jBommottet/TB-Driver-Brushless/Driver050621/CommandBoard/Project Outputs for CommandBoard/CommandBoard.xlsx

Comment | Designator | Quantity | Mouser number | Digikey number | Other number | Link
CAP CER 10uF 0603 |  | 4 |  | C0603C106M8PAC7867 |  | https://www.digikey.ch/product-detail/fr/C0603C106M8PAC7867/399-14945-1-ND/7382494?itemSeq=363421899
CAP CER 4.7uF 0603 |  | 2 |  | C0603C475K9PACTU |  | https://www.digikey.ch/product-detail/fr/kemet/C0603C475K9PACTU/399-3482-1-ND/754775
CAP CER 1uF 0603 |  | 1 |  | C0603C105K4RACTU |  | https://www.digikey.ch/product-detail/fr/C0603C105K4RACTU/399-7847-1-ND/3471570?itemSeq=363415969
CAP CER 1nF 0603 |  | 3 |  | C0603C102K8RACTU |  | https://www.digikey.ch/product-detail/fr/C0603C102K8RACTU/399-8984-1-ND/3522501?itemSeq=363415954
CAP CER 100nF 0603 |  | 25 |  | C0603C104K8RACTU |  | https://www.digikey.ch/product-detail/fr/C0603C104K8RACTU/399-1095-1-ND/411370?itemSeq=363415948
CAP CER 4.7nF 0603 |  | 18 |  | C0603C475M8PACTU |  | https://www.digikey.ch/product-detail/fr/C0603C475M8PACTU/399-9100-1-ND/3522617?itemSeq=363422440
CAP CER 22uF 0603 |  | 16 |  | C0603C226M9PACTU |  | https://www.digikey.ch/product-detail/fr/C0603C226M9PACTU/399-C0603C226M9PACTUCT-ND/14010171?itemSeq=363420624
DIODE SCHOTTKY 10V 2A SMA |  | 2 |  | MBRA210LT3G |  | https://www.digikey.ch/product-detail/fr/MBRA210LT3G/MBRA210LT3GOSCT-ND/917974?itemSeq=363445154
DIODE ZENER 6.8V 1W SMA |  | 1 |  | SMAZ6V8-13-F |  | https://www.digikey.ch/product-detail/fr/SMAZ6V8-13-F/SMAZ6V8-FDICT-ND/725075?itemSeq=363447033
FUSE 1.5A 5V FAST 0603 SMD |  | 1 |  | 04000026NR |  | https://www.digikey.ch/product-detail/fr/04000026NR/F12132CT-ND/10271167?itemSeq=363445570
CONNECT 2pos 90° |  | 2 |  |  | 62000211121 | https://www.we-online.com/catalog/en/PHD_2_00_THT_PIN_HEADER_6200XX11121
IND SMD 2020 |  | 1 |  | TFM201610ALM-R47MTAA |  | https://www.digikey.ch/product-detail/fr/tdk-corporation/TFM201610ALM-R47MTAA/445-174184-1-ND/5812324
IND SMD 6.8UH 0603 |  | 1 |  | MLF1608E6R8JTD25 |  | https://www.digikey.ch/product-detail/fr/MLF1608E6R8JTD25/445-173923-1-ND/5808629?itemSeq=363423079
RES SMD 2K2 0603 |  | 3 |  | RMCF0603FT2K20 |  | https://www.digikey.ch/product-detail/fr/stackpole-electronics-inc/RMCF0603FT2K20/RMCF0603FT2K20CT-ND/1943011
RES SMD 100R 0603 |  | 1 |  | RMCF0603FT100R |  | https://www.digikey.ch/product-detail/fr/RMCF0603FT100R/RMCF0603FT100RCT-ND/1942965?itemSeq=363423585
RES SMD 4.7k 0603 |  | 2 |  | RMCF0603FT4K70 |  | https://www.digikey.ch/product-detail/fr/RMCF0603FT4K70/RMCF0603FT4K70CT-ND/1943033?itemSeq=363423649
RES SMD 10R 0603 |  | 1 |  | RNCP0603FTD10R0 |  | https://www.digikey.ch/product-detail/fr/stackpole-electronics-inc/RNCP0603FTD10R0/RNCP0603FTD10R0CT-ND/2240413
RES SMD 120R 0603 |  | 1 |  | RMCF0603FT120R |  | https://www.digikey.ch/product-detail/fr/RMCF0603FT120R/RMCF0603FT120RCT-ND/1942967?itemSeq=363423557
RES 10K SMD 0603 |  | 18 |  | RMCF0603FT10K0 |  | https://www.digikey.ch/product-detail/fr/RMCF0603FT10K0/RMCF0603FT10K0CT-ND/1943057?itemSeq=363415693
DC DC CONVERTER 5V-3.3V |  | 1 |  | MPM3805GQB-33-Z |  | https://www.digikey.ch/product-detail/fr/MPM3805GQB-33-Z/1589-1986-1-ND/9748501?itemSeq=363447105
DC DC CONVERTER 5V-1.2V |  | 1 |  | MPM3805GQB-12-Z |  | https://www.digikey.ch/product-detail/fr/MPM3805GQB-12-Z/1589-1983-1-ND/9748498?itemSeq=363447114
DC DC CONVERTER 5V-12V |  | 1 |  | MEE3S0512SC |  | https://www.digikey.ch/product-detail/fr/MEE3S0512SC/811-2358-5-ND/3029000?itemSeq=363441799
IC TRANSCEIVER CAN |  | 1 |  | SN65HVD231QDRQ1 |  | https://www.digikey.ch/product-detail/fr/SN65HVD231QDRQ1/296-15380-1-ND/571269?itemSeq=363441788
SUPERVISOR 1 CHANNEL |  | 1 |  | ADM823TYRJZ-R7 |  | https://www.digikey.ch/product-detail/fr/ADM823TYRJZ-R7/ADM823TYRJZ-R7CT-ND/2467723?itemSeq=363441633
DSP TMS320F28388D |  | 1 | 595-F28388DPTPS |  |  | https://www.mouser.ch/ProductDetail/Texas-Instruments/F28388DPTPS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
RAM |  | 1 |  | AS6C4008-55SINTR |  | https://www.digikey.ch/product-detail/fr/AS6C4008-55SINTR/1450-AS6C4008-55SINCT-ND/12088888?itemSeq=364804926
CONNECT SMD 16pos 180° |  | 2 |  |  | 62101621021 | https://www.we-online.com/catalog/en/PHD_1_27_SMT_DUAL_PIN_HEADER_6210XX21021
CONNECT SMD 10pos 180° |  | 2 |  |  | 62131021021
CONNECT 2pos 90° |  | 1 |  | 395126002 |  | https://www.digikey.ch/product-detail/fr/molex/0395126002/WM25774-ND/2736022 | + connecteur opposé
CONNECT SMD 14pos 180° |  | 3 |  |  | 62101421021 | https://www.we-online.com/catalog/en/PHD_1_27_SMT_DUAL_PIN_HEADER_6210XX21021
CONNECT SMD 5pos 180° |  | 3 |  |  | 62000611121 | https://www.we-online.com/catalog/en/PHD_2_00_THT_PIN_HEADER_6200XX11121
CONNECT SMD 4pos 180° |  | 4 |  | 215079-4 |  | https://www.digikey.ch/product-detail/fr/te-connectivity-amp-connectors/215079-4/A107031CT-ND/3488592
CRYSTAL 12.0000MHZ |  | 1 |  | CX3225SB12000D0GZJC1 |  | https://www.digikey.ch/product-detail/fr/CX3225SB12000D0GZJC1/1253-1696-1-ND/5995243?itemSeq=364400560
