jBommottet/TB-Driver-Brushless/Driver050621/DCDC_5V/Project Outputs for DCDC_5V/DCDC_5V.xlsx

Comment | Quantity | Digikey number | Other number | Link
CAP CER 3.3uF 1206 | 1 | CGA5L3X7S2A335K160AB |  | https://www.digikey.ch/product-detail/fr/CGA5L3X7S2A335K160AB/445-15583-1-ND/4278756?itemSeq=363420762
CAP CER 2.2uF 1206 | 1 | CNC5L1X7R1N225K160AE |  | https://www.digikey.ch/product-detail/fr/CNC5L1X7R1N225K160AE/445-181654-1-ND/10240641?itemSeq=363420761
CAP CER 22uF 0603 | 1 | C0603C226M9PACTU |  | https://www.digikey.ch/product-detail/fr/C0603C226M9PACTU/399-C0603C226M9PACTUCT-ND/14010171?itemSeq=363420624
DIODE SCHOTTKY 100V 1A SOD123 | 2 | PMEG10010ELRX |  | https://www.digikey.ch/product-detail/fr/PMEG10010ELRX/1727-2394-1-ND/5436140?itemSeq=363416438
IND SMD 4.7uH 2020 | 1 | DFE252012F-4R7M=P2 |  | https://www.digikey.ch/product-detail/fr/DFE252012F-4R7M%3dP2/490-13051-1-ND/5812763?itemSeq=363420526
DCDC 5V 1.5A | 1 | RPMH5.0-1.5 |  | https://www.digikey.ch/product-detail/fr/RPMH5.0-1.5/945-RPMH5.0-1.5CT-ND/13549175?itemSeq=363421652
CONNECT HEADER 5pos 180° | 1 |  | 62000611821 | https://www.we-online.com/catalog/en/PHD_2_00_SOCKET_HEADER_6200XX11821
