jBommottet/TB-Driver-Brushless/Driver050621/PowerBoard/Project Outputs for PowerBoard/PowerBoard.xlsx

LISTE POUR 1 CARTE
Comment | Quantity | Mouser number | Digikey number | Other number | Link
CAP CER 10uF 1210 | 20 |  | C3225X7R1N106K250AC |  | https://www.digikey.ch/product-detail/fr/tdk-corporation/C3225X7R1N106K250AC/445-C3225X7R1N106K250ACCT-ND/10415004
CAP CER 100nF 0603 | 4 |  | C0603C104K8RACTU |  | https://www.digikey.ch/product-detail/fr/C0603C104K8RACTU/399-1095-1-ND/411370?itemSeq=363415948
CAP CER 1nF 0603 | 6 |  | C0603C102K8RACTU |  | https://www.digikey.ch/product-detail/fr/C0603C102K8RACTU/399-8984-1-ND/3522501?itemSeq=363415954
CAP CER 1uF 0603 | 6 |  | C0603C105K4RACTU |  | https://www.digikey.ch/product-detail/fr/C0603C105K4RACTU/399-7847-1-ND/3471570?itemSeq=363415969
CAP CER 47nF 0603 | 4 |  | C0603C473K8RAC7867 |  | https://www.digikey.ch/product-detail/fr/C0603C473K8RAC7867/399-14522-1-ND/7103814?itemSeq=363415965
CAP CER 4.7nF 0603 | 2 |  | C0603C472K8RACTU |  | https://www.digikey.ch/product-detail/fr/C0603C472K8RACTU/399-9092-1-ND/3522609?itemSeq=363415967
CAP CER 22uF 0603 | 2 |  | JMK107BBJ226MA-T |  | https://www.digikey.ch/product-detail/fr/taiyo-yuden/JMK107BBJ226MA-T/587-5444-2-ND/7067029
DIODE SCHOTTKY 100V 1A SOD123 | 3 |  | PMEG10010ELRX |  | https://www.digikey.ch/product-detail/fr/PMEG10010ELRX/1727-2394-1-ND/5436140?itemSeq=363416438
CONNECT 2pos 90° | 1 |  | 1778764 |  | https://www.digikey.ch/product-detail/fr/1778764/277-2315-1-ND/2625585?itemSeq=363625166 | + connecteur opposé
CONNECT 3pos 90° | 1 |  | 1778777 |  | https://www.digikey.ch/product-detail/fr/1778777/277-2316-1-ND/2625586?itemSeq=363625120 | + connecteur opposé
IND SMD 220nH 1008 | 1 |  | SRP2510A-R22M |  | https://www.digikey.ch/product-detail/fr/bourns-inc/SRP2510A-R22M/SRP2510A-R22MCT-ND/7354833
MOSFET N-CH 80V | 6 |  | NTMFSC004N08MC |  | https://www.digikey.ch/product-detail/fr/NTMFSC004N08MC/488-NTMFSC004N08MCCT-ND/12181457?itemSeq=363416444
RES 18K SMD 0603 | 4 |  | RMCF0603FT18K0 |  | https://www.digikey.ch/product-detail/fr/RMCF0603FT18K0/RMCF0603FT18K0CT-ND/2417954?itemSeq=363415700
RES 1K SMD 0603 | 6 |  | RMCF0603FT1K00 |  | https://www.digikey.ch/product-detail/fr/RMCF0603FT1K00/RMCF0603FT1K00CT-ND/1942996?itemSeq=363415659
RES 5R6 SMD 0603 | 6 |  | RMCF0603FT5R60 |  | https://www.digikey.ch/product-detail/fr/RMCF0603FT5R60/738-RMCF0603FT5R60CT-ND/4425116?itemSeq=363415636
RES 220R SMD 0603 | 6 |  | RMCF0603FT220R |  | https://www.digikey.ch/product-detail/fr/RMCF0603FT220R/RMCF0603FT220RCT-ND/1942973?itemSeq=363415651
RES 20k SMD 0603 | 2 |  | RMCF0603FT20K0 |  | https://www.digikey.ch/product-detail/fr/RMCF0603FT20K0/RMCF0603FT20K0CT-ND/1943075?itemSeq=363415704
RES 10K SMD 0603 | 2 |  | RMCF0603FT10K0 |  | https://www.digikey.ch/product-detail/fr/RMCF0603FT10K0/RMCF0603FT10K0CT-ND/1943057?itemSeq=363415693
SENSOR DIGITAL -40C-150C | 1 |  | ADT7301ARTZ-REEL7 |  | https://www.digikey.ch/product-detail/fr/ADT7301ARTZ-REEL7/ADT7301ARTZ-REEL7CT-ND/1140631?itemSeq=363416449
Op Amp 4ch | 1 |  | MCP629-E/ML |  | https://www.digikey.ch/product-detail/fr/MCP629-E%2fML/MCP629-E%2fML-ND/2721005?itemSeq=363416452
GATE DRIVER 2.5A | 6 |  | SI8220BB-D-ISR |  | https://www.digikey.ch/product-detail/fr/SI8220BB-D-ISR/336-4765-1-ND/8611031?itemSeq=363416457
Op Amp 2ch | 1 | MCP622-E/MF |  |  | https://www.mouser.ch/ProductDetail/Microchip-Technology/MCP622-E-MF?qs=E6wAi2XWqcMnrAekjrllAQ%3D%3D
Analog Switch 2:1 2ch | 1 | ADG854BCPZ-REEL7 |  |  | https://www.mouser.ch/ProductDetail/Analog-Devices/ADG854BCPZ-REEL7?qs=BpaRKvA4VqFJEnBHLg6w9Q%3D%3D
IC CURRENT SENSOR | 2 |  | MLX91221KDC-ABF-025-SP |  | https://www.digikey.ch/product-detail/fr/melexis-technologies-nv/MLX91221KDC-ABF-025-SP/413-MLX91221KDC-ABF-025-SP-ND/13572120
CONNECT SMD 16pos 2row 180° | 1 |  |  | 62301621021 | https://www.we-online.com/catalog/en/PHD_1_27_SMT_DUAL_SOCKET_HEADER_6230XX21021
CONNECT SMD 10pos 2row 180° | 1 |  |  | 62301021021
