jBommottet/TB-Driver-Brushless/Driver050621/InterfaceBoard/Project Outputs for InterfaceBoard/InterfaceBoard.xlsx

LISTE POUR 1 CARTE
Comment | Quantity | Digikey number | Other number | Link
CAP CER 1nF 0603 | 3 | C0603C102K8RACTU |  | https://www.digikey.ch/product-detail/fr/C0603C102K8RACTU/399-8984-1-ND/3522501?itemSeq=363415954
CAP CER 10nF 0603 | 1 | C0603C103K8RACTU |  | https://www.digikey.ch/product-detail/fr/C0603C103K8RACTU/399-11132-1-ND/4357813?itemSeq=363415943
CAP CER 100nF 0603 | 14 | C0603C104K8RACTU |  | https://www.digikey.ch/product-detail/fr/C0603C104K8RACTU/399-1095-1-ND/411370?itemSeq=363415948
CAP CER 10pF 0603 | 4 | C0603C100K8RAC7867 |  | https://www.digikey.ch/product-detail/fr/C0603C100K8RAC7867/399-17563-1-ND/8572563?itemSeq=363415936
CAP CER 22uF 0603 | 1 | JMK107BBJ226MA-T |  | https://www.digikey.ch/product-detail/fr/taiyo-yuden/JMK107BBJ226MA-T/587-5444-2-ND/7067029
CONNECT SMD 6pos 180° | 2 | 7-188275-6 |  | https://www.digikey.ch/product-detail/fr/7-188275-6/A99474CT-ND/1955776?itemSeq=363420047
CONNECT SMD 8pos 180° | 2 | 7-188275-8 |  | https://www.digikey.ch/product-detail/fr/7-188275-8/A99475CT-ND/1955777?itemSeq=363420050
CONNECT 2pos 180° | 1 |  | 62000211821 | https://www.we-online.com/catalog/en/PHD_2_00_SOCKET_HEADER_6200XX11821
IND SMD 2.2uH 0603 | 1 | MLZ1608N2R2LT000 |  | https://www.digikey.ch/product-detail/fr/tdk-corporation/MLZ1608N2R2LT000/445-6754-1-ND/2523575
RES SMD 10R 0603 | 1 | RMCF0603FT10R0 |  | https://www.digikey.ch/product-detail/fr/RMCF0603FT10R0/RMCF0603FT10R0CT-ND/1942943?itemSeq=363415646
RES SMD 560R 0603 | 6 | RMCF0603FT560R |  | https://www.digikey.ch/product-detail/fr/RMCF0603FT560R/738-RMCF0603FT560RCT-ND/4425112?itemSeq=363415656
RES SMD 1K 0603 | 9 | RMCF0603FT1K00 |  | https://www.digikey.ch/product-detail/fr/RMCF0603FT1K00/RMCF0603FT1K00CT-ND/1942996?itemSeq=363415659
RES SMD 2K2 0603 | 3 | RMCF0603FT2K20 |  | https://www.digikey.ch/product-detail/fr/RMCF0603FT2K20/RMCF0603FT2K20CT-ND/1943011?itemSeq=363415690
RES SMD 10K 0603 | 8 | RMCF0603FT10K0 |  | https://www.digikey.ch/product-detail/fr/RMCF0603FT10K0/RMCF0603FT10K0CT-ND/1943057?itemSeq=363415693
RES SMD 0603 | 2 | RNCS0603BKE10K0 |  | https://www.digikey.ch/product-detail/fr/stackpole-electronics-inc/RNCS0603BKE10K0/RNCS0603BKE10K0CT-ND/1800113
IC ADC 12BIT | 1 | ADS7883SDBVT |  | https://www.digikey.ch/product-detail/fr/ADS7883SDBVT/296-23635-1-ND/1919069?itemSeq=363416073
Analog Switch 2:1 1ch | 5 | NC7SB3157P6X |  | https://www.digikey.ch/product-detail/fr/NC7SB3157P6X/NC7SB3157P6XCT-ND/1305384?itemSeq=365255241
OPAMP 1 CIRCUIT | 3 | TS951RIYLT |  | https://www.digikey.ch/product-detail/fr/stmicroelectronics/TS951RIYLT/497-15708-1-ND/5267991
IC INVERTER 3CH | 1 | TC7WH14FU,LJ(CT |  | https://www.digikey.ch/product-detail/fr/toshiba-semiconductor-and-storage/TC7WH14FU-LJ-CT/TC7WH14FULJ-CTCT-ND/870765
COMP 1 CIRCUIT | 3 | LMV7239M5/NOPB |  | https://www.digikey.ch/product-detail/fr/texas-instruments/LMV7239M5-NOPB/LMV7239M5-NOPBCT-ND/638723
IC RECEIVER 0/4 | 1 | AM26C32IPWR |  | https://www.mouser.ch/ProductDetail/Texas-Instruments/AM26C32IPWR?qs=iSMark9AYDVYrMWEOajyrw%3D%3D
CONNECT SMD 16pos 180° | 1 |  | 62301621021 | https://www.we-online.com/catalog/en/PHD_1_27_SMT_DUAL_SOCKET_HEADER_6230XX21021
CONNECT HEADER 5pos 180° | 1 |  | 62000611821 | https://www.we-online.com/catalog/en/PHD_2_00_SOCKET_HEADER_6200XX11821
