jBommottet/TB-Driver-Brushless/Driver050621/CommandBoard/UD_composants/LQH3NPN151MGRL.STEP

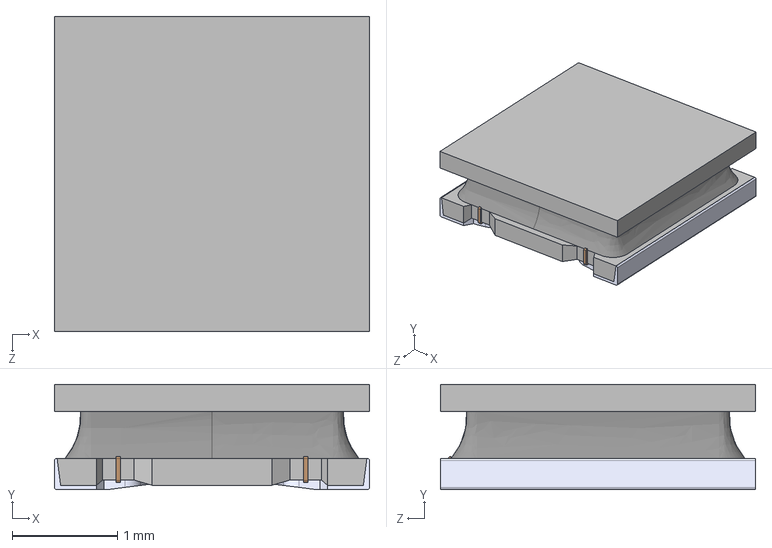
[picture p2: CAD file, 2021-06-05]
Driver050621/CommandBoard/UD_composants/LQH3NPN151MGRL.STEP
3.00 x 1.00 x 3.00 mm
