jBommottet/TB-Driver-Brushless/Driver050621/InterfaceBoard/UD_Composant/c-7-188275-8-u-3d.stp

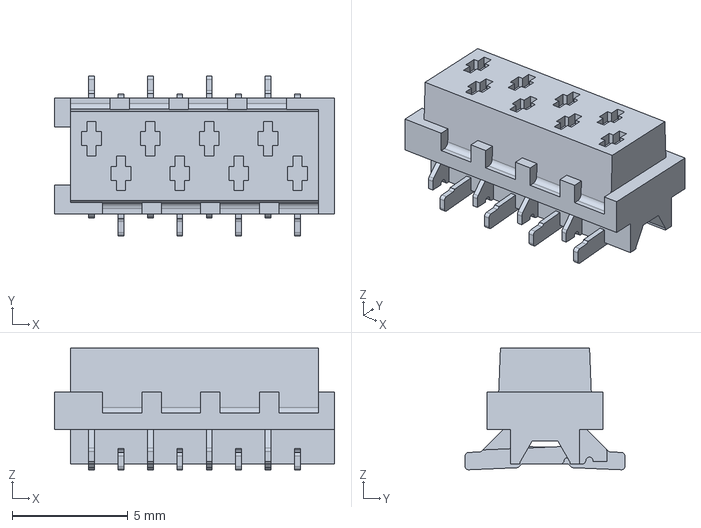
[picture p3: CAD file, 2021-06-05]
Driver050621/InterfaceBoard/UD_Composant/c-7-188275-8-u-3d.stp
12.1 x 6.90 x 5.25 mm
