jBommottet/TB-Driver-Brushless/Driver050621/PowerBoard/UD_Componant/GCT_BG30604A10400LB/BG306-04-A-1-0400-L-B.stp

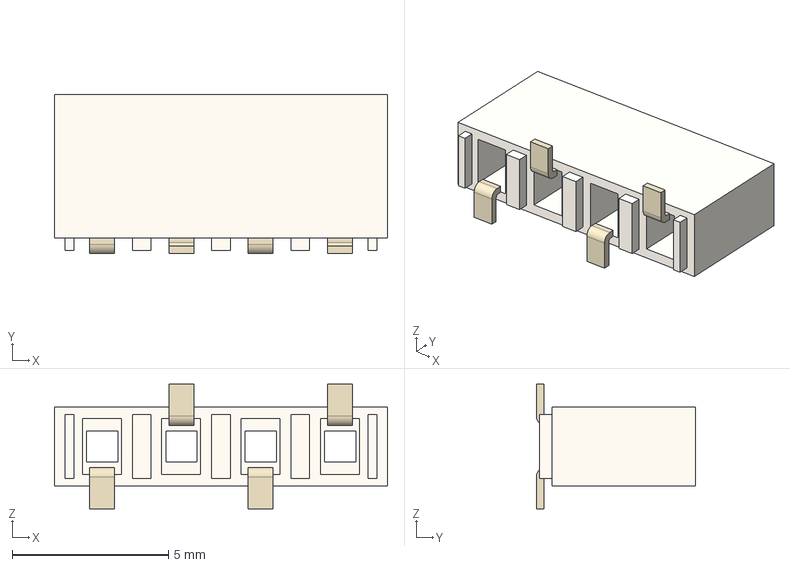
[picture p4: CAD file, 2021-06-05]
Driver050621/PowerBoard/UD_Componant/GCT_BG30604A10400LB/BG306-04-A-1-0400-L-B.stp
10.7 x 5.10 x 4.00 mm
_BG306-04-A-1-0400-L-B_D
_BG306-04-A-1-0400-L-B_H
_BG306-04-A-1-0400-L-B_P x 4
