jBommottet/TB-Driver-Brushless/Driver050621/PowerBoard/UD_Componant/pxc_1778764_01_PTSM-0-5-2-HH-2-5-SMD-R32_3D.stp

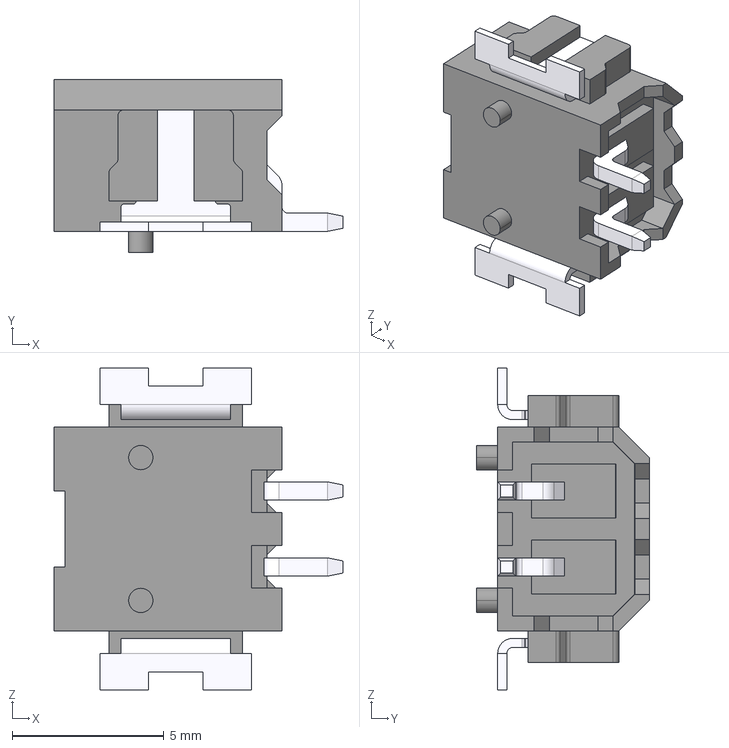
[picture p5: CAD file, 2021-06-05]
Driver050621/PowerBoard/UD_Componant/pxc_1778764_01_PTSM-0-5-2-HH-2-5-SMD-R32_3D.stp
9.50 x 5.70 x 10.6 mm
