jBommottet/TB-Driver-Brushless/Driver050621/PowerBoard/UD_Componant/ul_ADT7301ARTZREEL7/AltiumDesigner/2021-04-29_10-53-14/RJ_6_ADI.step

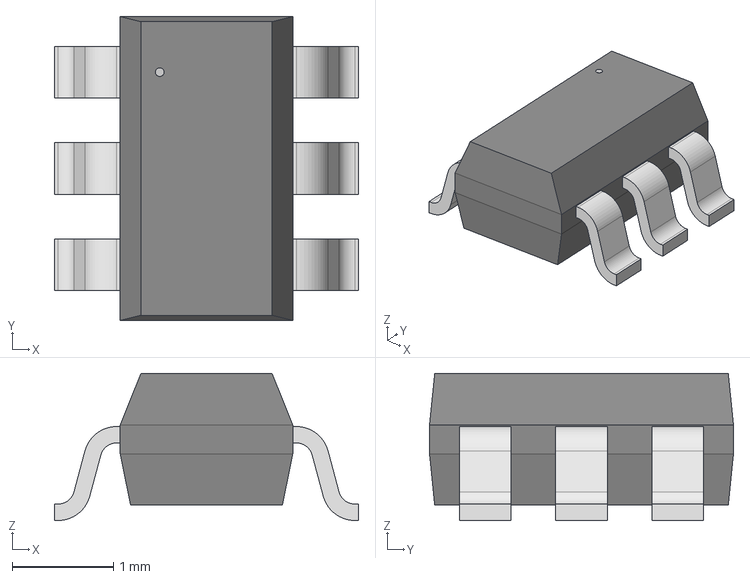
[picture p6: CAD file, 2021-06-05]
Driver050621/PowerBoard/UD_Componant/ul_ADT7301ARTZREEL7/AltiumDesigner/2021-04-29_10-53-14/RJ_6_ADI.step
3.00 x 3.00 x 1.45 mm
