jBommottet/TB-Driver-Brushless/Driver050621/PowerBoard/UD_Componant/ul_NTMFSC004N08MC/AltiumDesigner/2021-04-29_10-36-20/DFN8_506EG_ONS.step

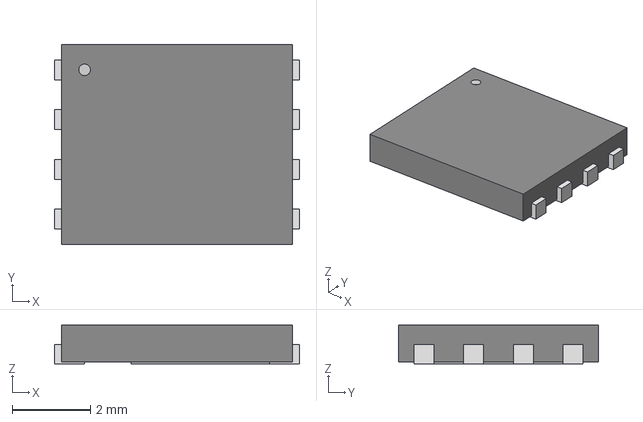
[picture p7: CAD file, 2021-06-05]
Driver050621/PowerBoard/UD_Componant/ul_NTMFSC004N08MC/AltiumDesigner/2021-04-29_10-36-20/DFN8_506EG_ONS.step
6.25 x 5.11 x 0.993 mm
