jBommottet/TB-Driver-Brushless/Driver050621/DCDC_5V/UD_Composant/RPMH5.0-1.5-CT--3DModel-STEP-1.STEP

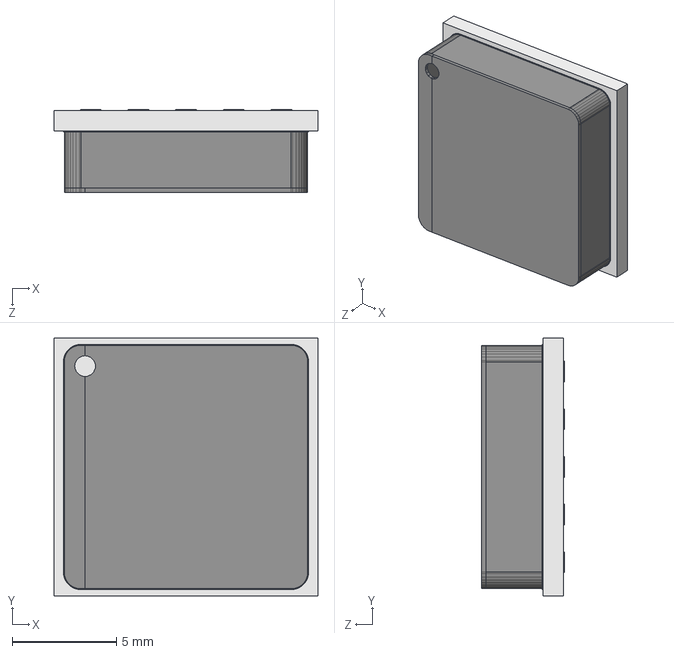
[picture p8: CAD file, 2021-06-05]
Driver050621/DCDC_5V/UD_Composant/RPMH5.0-1.5-CT--3DModel-STEP-1.STEP
12.7 x 12.4 x 3.97 mm
