jBommottet/TB-Driver-Brushless/Driver050621/PowerBoard/UD_Componant/pxc_1778777_01_PTSM-0-5-3-HH-2-5-SMD-R32_3D.stp

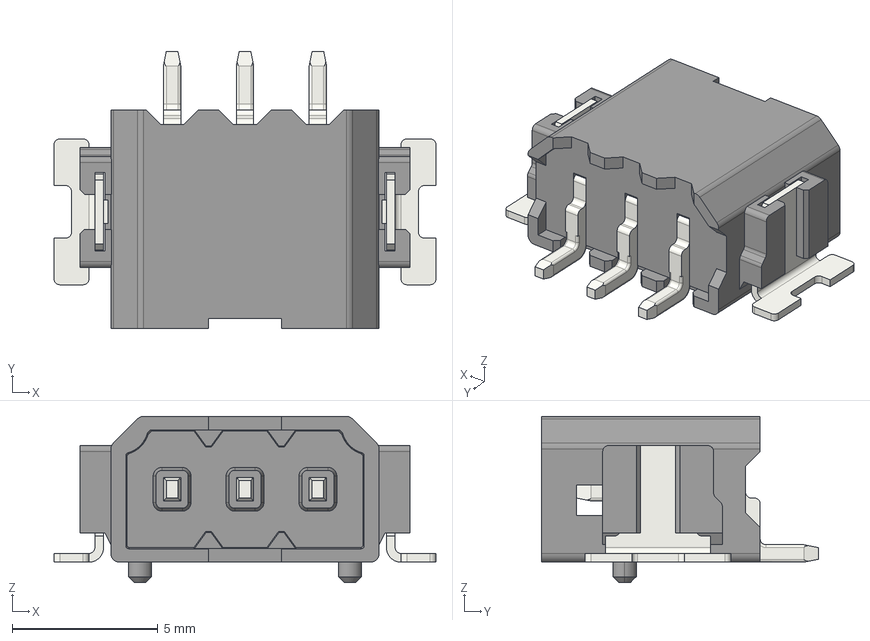
[picture p10: CAD file, 2021-06-05]
Driver050621/PowerBoard/UD_Componant/pxc_1778777_01_PTSM-0-5-3-HH-2-5-SMD-R32_3D.stp
13.1 x 9.50 x 5.70 mm
LR_0_5_2_5_SMD_ANKER.1 x 2
LP_PTSM_0_5_2_5_G_SMD_METALL_H_0_00 x 3
AT_PTSM_0_5_2_5_HH_SMD
