jBommottet/TB-Driver-Brushless/Driver050621/CommandBoard/UD_composants/mps_dcdc_mee3s_sc_a.step

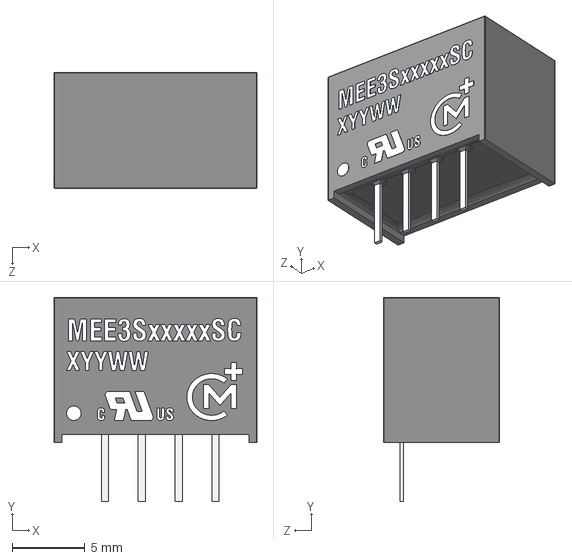
[picture p11: CAD file, 2021-06-05]
Driver050621/CommandBoard/UD_composants/mps_dcdc_mee3s_sc_a.step
14.0 x 14.1 x 8.02 mm
