jBommottet/TB-Driver-Brushless/Driver050621/PowerBoard/UD_Componant/User Library-UQFN10 1_4x1_8mm 0_4 pitch with white mark.step

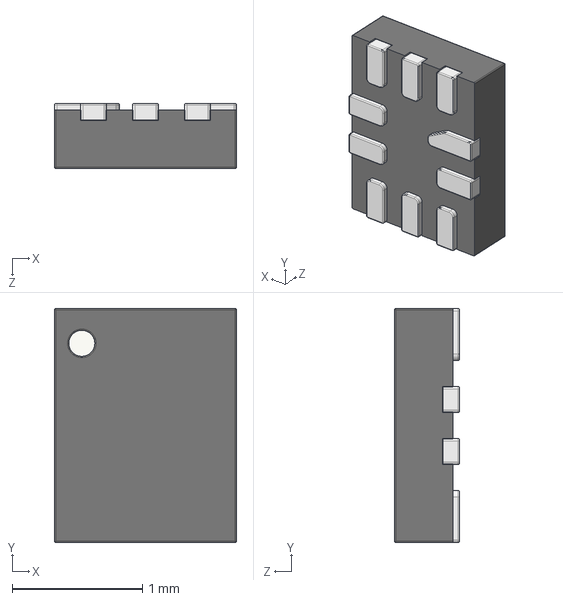
[picture p12: CAD file, 2021-06-05]
Driver050621/PowerBoard/UD_Componant/User Library-UQFN10 1_4x1_8mm 0_4 pitch with white mark.step
1.40 x 1.80 x 0.5 mm
