jBommottet/TB-Driver-Brushless/Driver050621/CommandBoard/UD_composants/c-188275-4-u-3d.stp

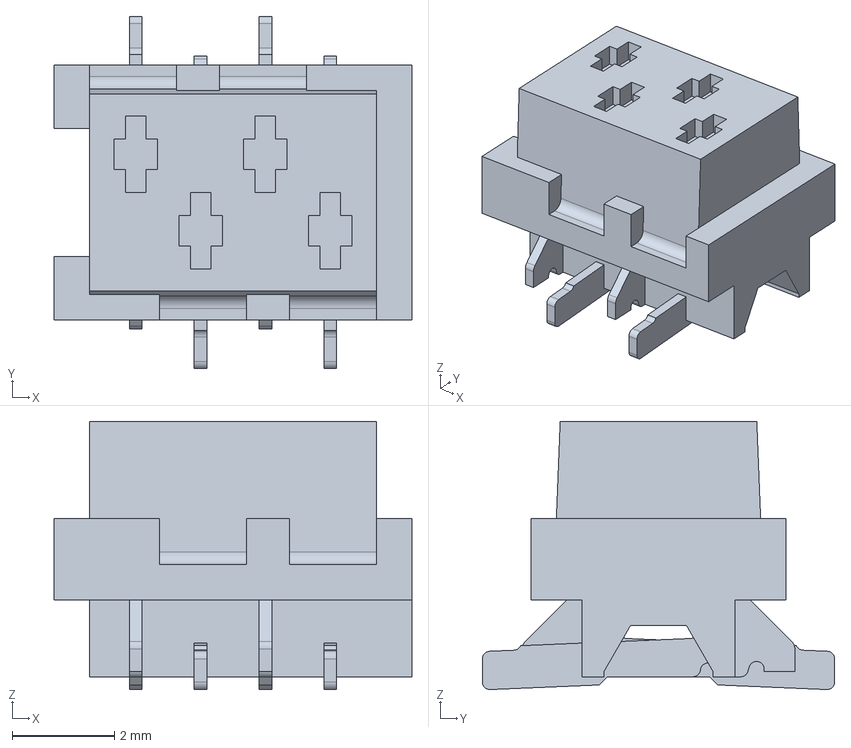
[picture p13: CAD file, 2021-06-05]
Driver050621/CommandBoard/UD_composants/c-188275-4-u-3d.stp
7.01 x 6.90 x 5.25 mm
