jBommottet/TB-Driver-Brushless/Driver050621/PowerBoard/UD_Componant/User Library-so8-3.step

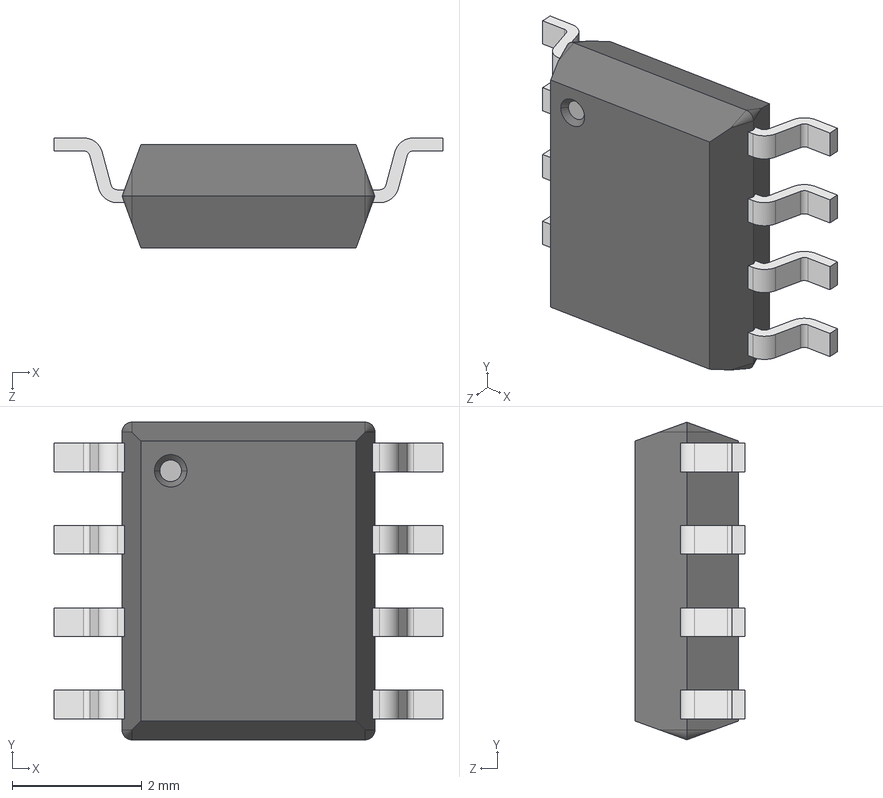
[picture p14: CAD file, 2021-06-05]
Driver050621/PowerBoard/UD_Componant/User Library-so8-3.step
6.00 x 4.90 x 1.70 mm
