jBommottet/TB-Driver-Brushless/Driver050621/PowerBoard/UD_Componant/User Library-SOD123W.step

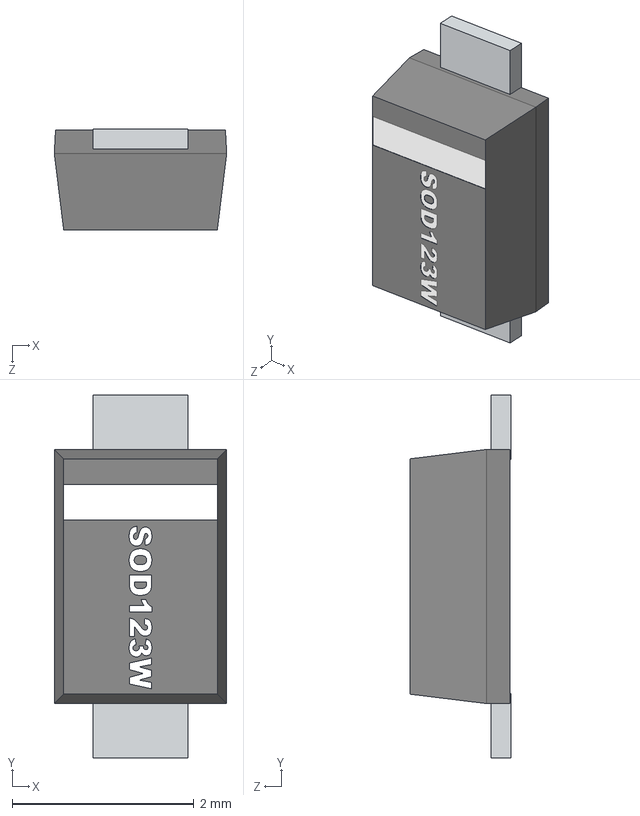
[picture p15: CAD file, 2021-06-05]
Driver050621/PowerBoard/UD_Componant/User Library-SOD123W.step
1.90 x 4.00 x 1.11 mm
