jBommottet/TB-Driver-Brushless/Driver050621/CommandBoard/UD_composants/connector4pins/62100421021 (rev1).stp

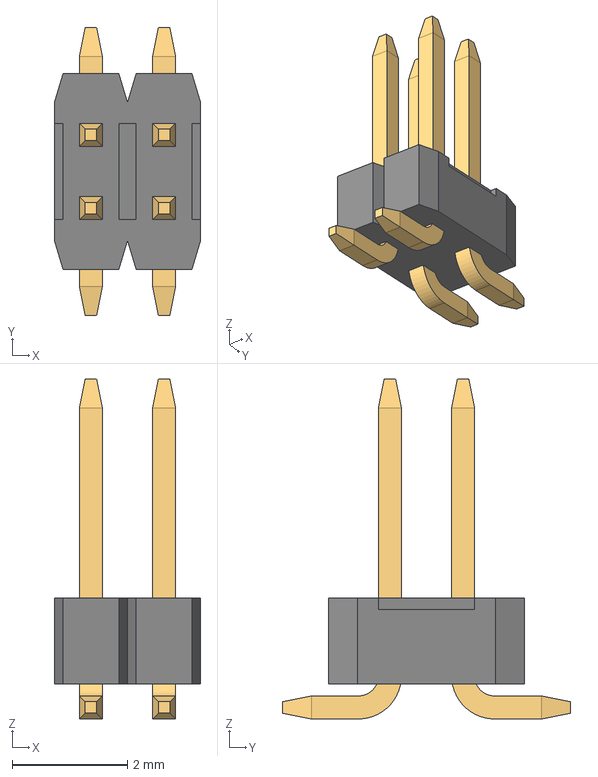
[picture p16: CAD file, 2021-06-05]
Driver050621/CommandBoard/UD_composants/connector4pins/62100421021 (rev1).stp
2.54 x 5.00 x 5.91 mm
621x0421021_Housing
6210xx21021_PIN x 4
