jBommottet/TB-Driver-Brushless/Driver050621/DCDC_5V/UD_Composant/62000611821-3pin.stp

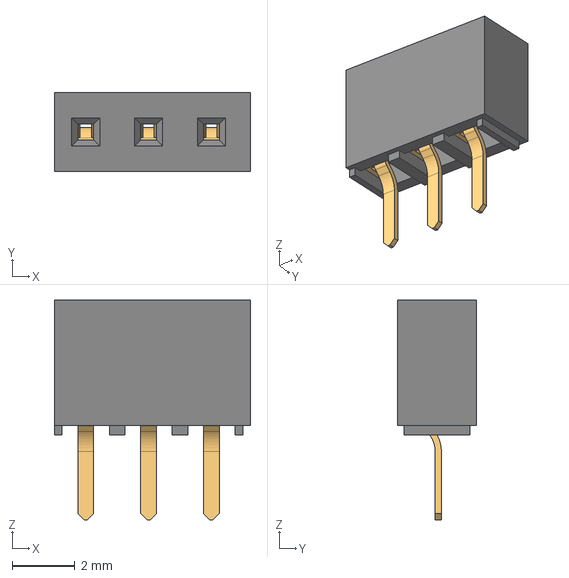
[picture p17: CAD file, 2021-06-05]
Driver050621/DCDC_5V/UD_Composant/62000611821-3pin.stp
6.25 x 2.50 x 7.00 mm
