jBommottet/TB-Driver-Brushless/(list of files, cad)

Other CAD files:
Driver050621/CommandBoard/UD_composants/62000611121 (rev1).stp
Driver050621/CommandBoard/UD_composants/62000611121-5pin.stp
Driver050621/InterfaceBoard/UD_Composant/62000611821-2pin.stp
Driver050621/InterfaceBoard/UD_Composant/62000611821.stp
Driver050621/PowerBoard/UD_Componant/connector4pins/62300421021 (rev1).stp
