jBommottet/TB-Driver-Brushless/(threads)

Thread 1 (2021-10-17):

Great project

Alvazz, 2021-10-17:
Great project, thanks for your open source, I have a question, if I want to adjust the nominal voltage to 48V, continuous current to 12A, peak current to 40A, do you have any good suggestions?

jBommottet, 2021-10-17:
Hi Alvazz,
I'm glad you like this project. In fact, it is only a prototype, I advise you to inspire you only and not to copy everything ... I am still a beginner in the field of electronic development.

To adapt this project to your use, you would mainly need to adjust the power board.
- Change the power transistors so that they support the energy you want to transmit to the motor. It is also necessary to pay attention to the losses of these, because it is converted into heat which must be dissipated.
- Adjust the gate drivers so that they can drive the new transistors.
- Adjust the three-phase bridge decoupling capacitors so as to have a low voltage ripple.
- And finally, we must review the routing between the components so that the PCB can withstand the current.

If you are looking to make a compact controller, I also recommend that you compromise between size and performance. Sometimes it is better to have a large component that works well and where you have a little bit of margin, than a super compact component but not suited to your project. At least if this is your first project in the field like it was for me.

I will gladly answer your future questions if you have others.

Alvazz, 2021-10-17:
This is my email: jasonzzpro@gmail.com, looking forward to your letter to me, we will further communicate via email

Thread 3 (2021-11-06):

Dear Author, Ask about the problem of the number of pcb layers

Alvazz, 2021-11-06:
Hi, I saw the names of some layers in the pcb layer file. What is the meaning of the PWR_MOT and ALIM_MOT layers?
