jBommottet/TB-Driver-Brushless/Driver050621/MicroBrushless/Assembly_schematic.pdf

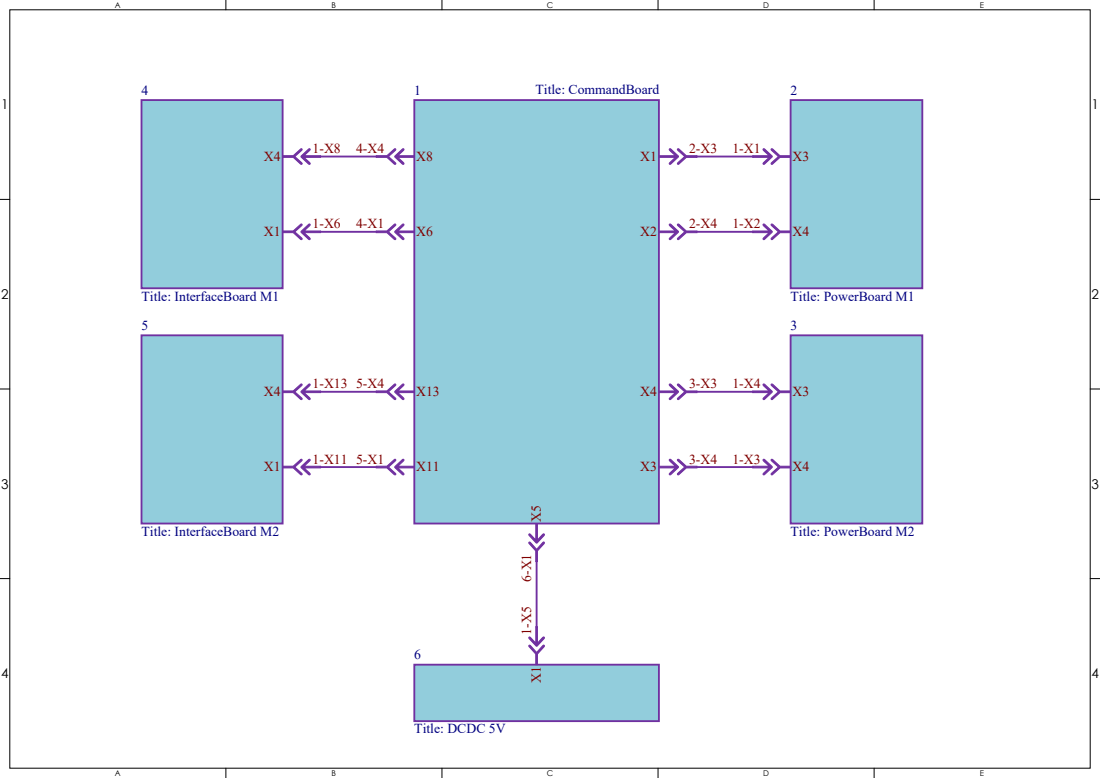
[picture p18: page 1]
Title: CommandBoard; Title: PowerBoard M1; Title: PowerBoard M2; Title: InterfaceBoard M1; Title: InterfaceBoard M2; Title: DCDC 5V
