jBommottet/TB-Driver-Brushless/Driver050621/CommandBoard/CommandBoard.pdf

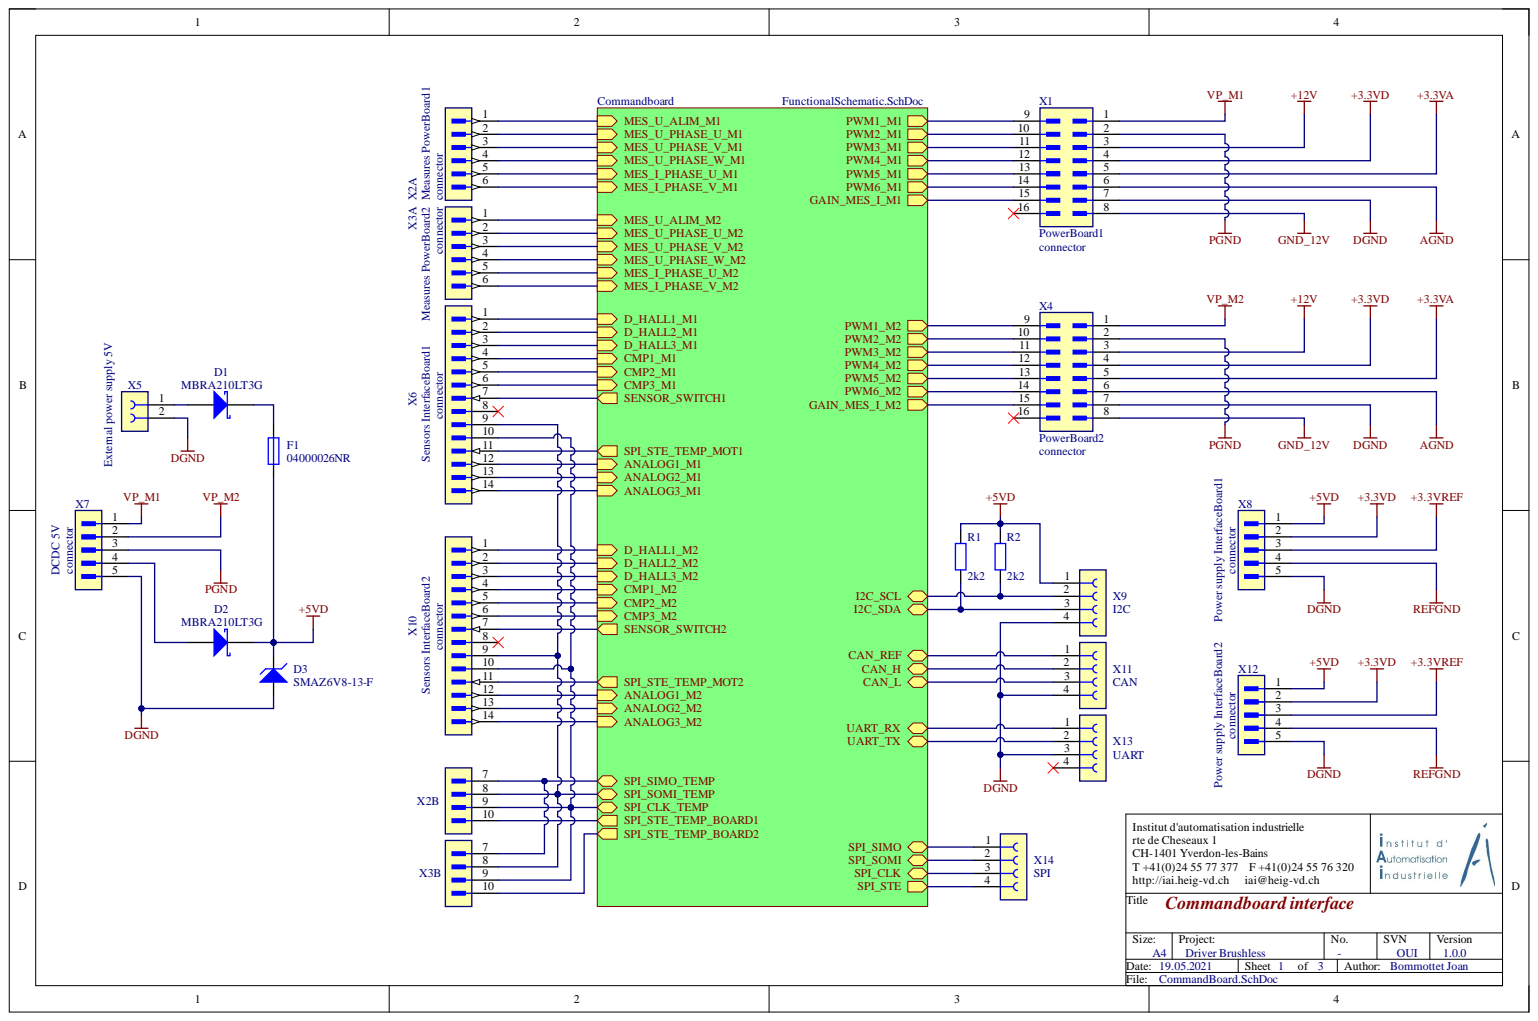
[picture p19: page 1]

Size : A 4 | Projec t : Dri ver Bru s h les s | N o . - | SV N O U I | Vers i o n 1.0 . 0

Dat e : 9.0 . | Shee t o f | A u t h o r : Bommo t tet J o an

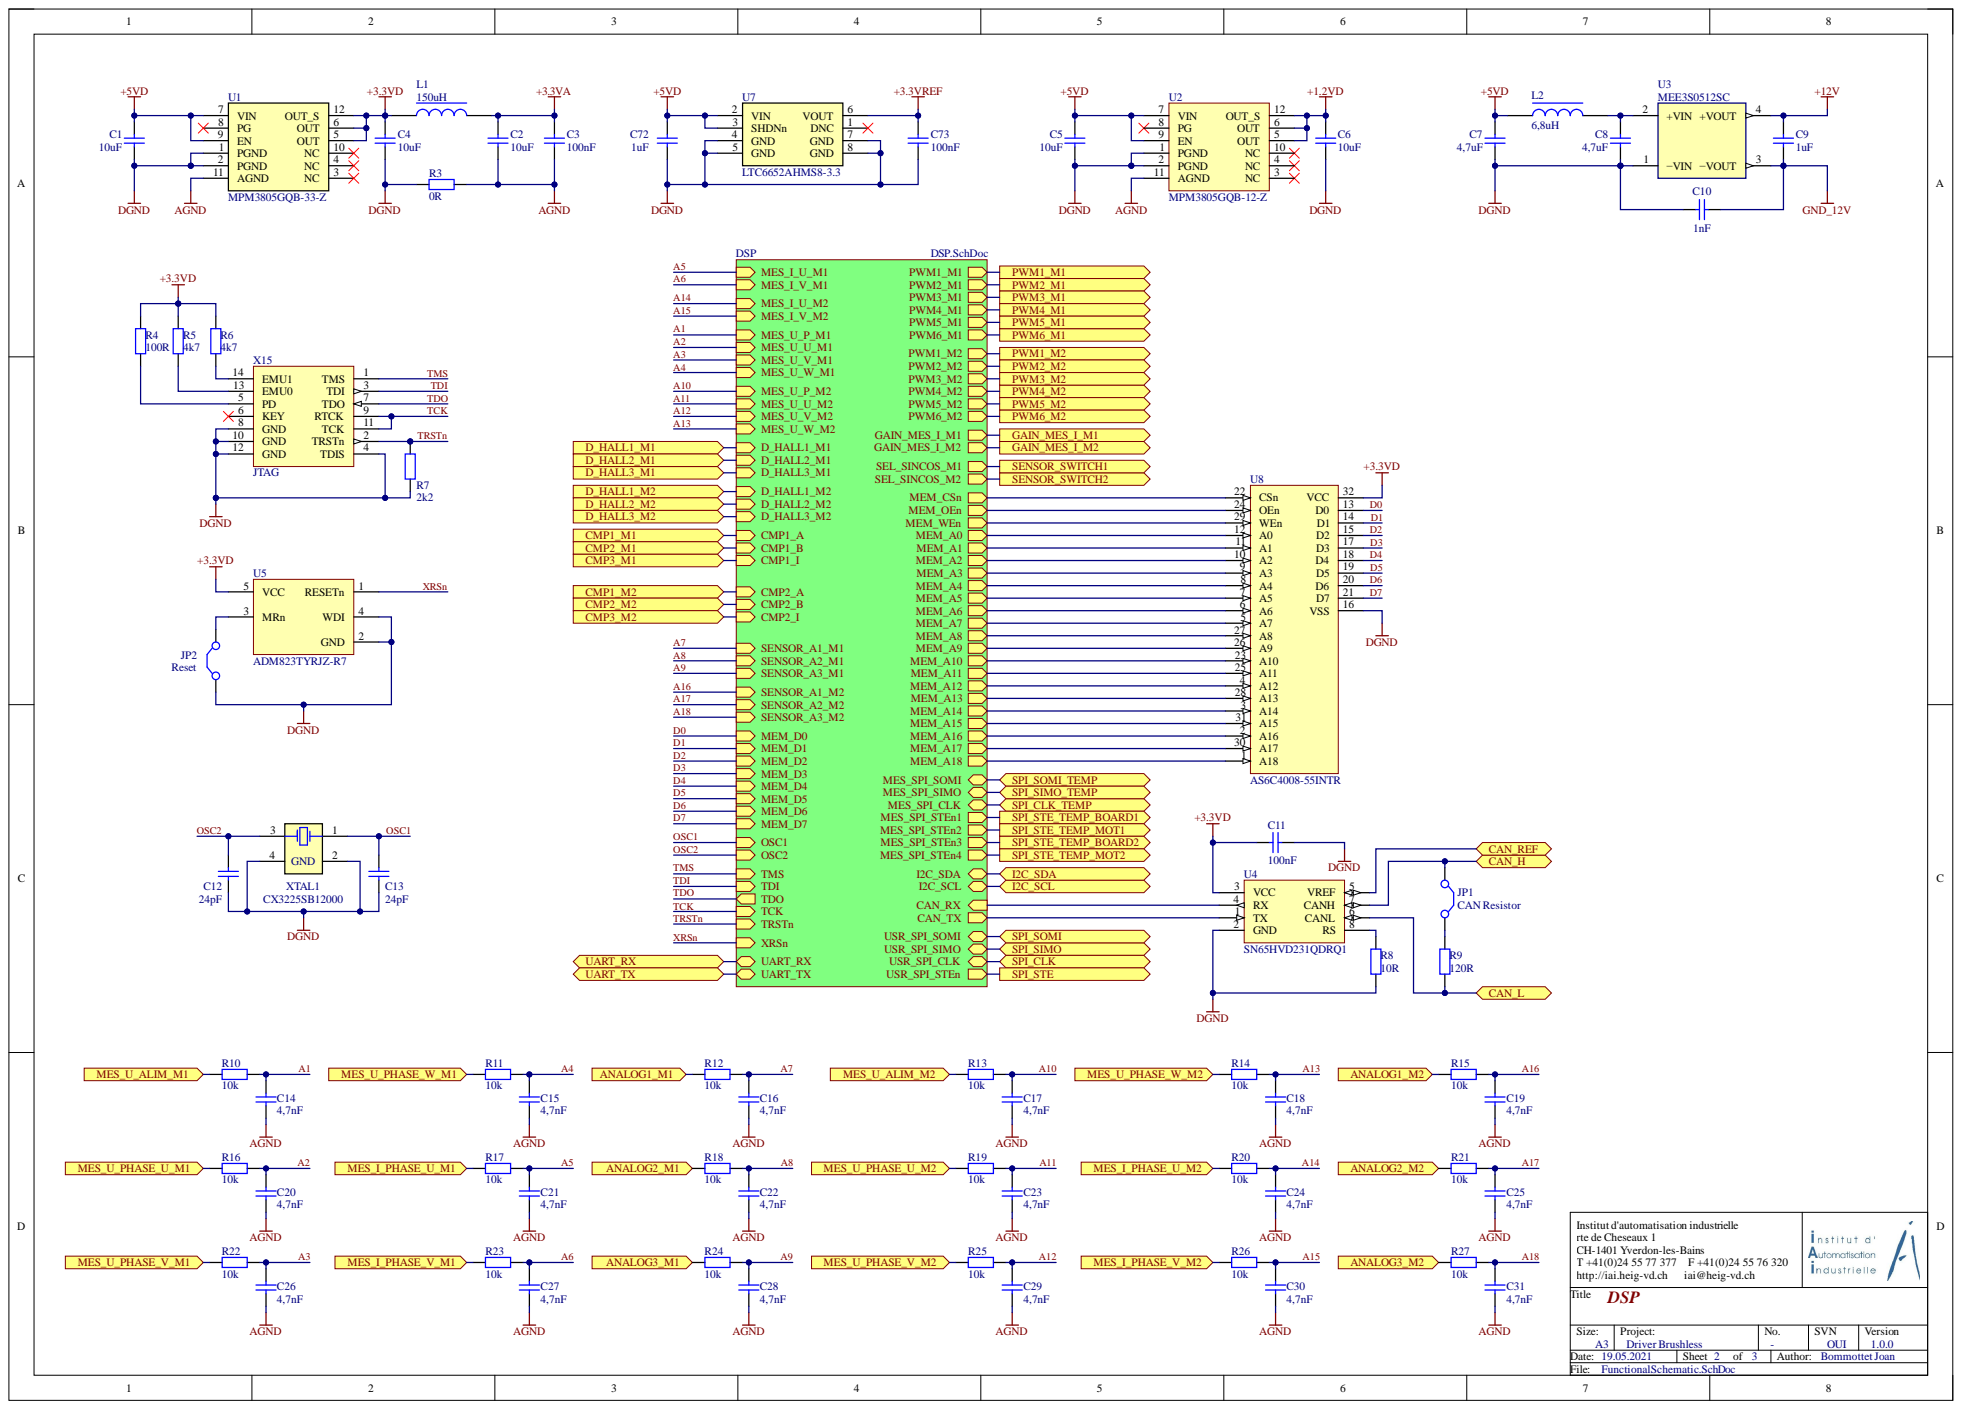
[picture p20: page 2]

Institut d'automatisation industrielle
rte de Cheseaux 1
CH-1401 Yverdon-les-Bains

Size: A3 | Project: DriverBrushless | No. - | SVN OUI | Version 1.0.0

Date: 19.05.2021 | Sheet 2 of 3 | Author: BommottetJoan

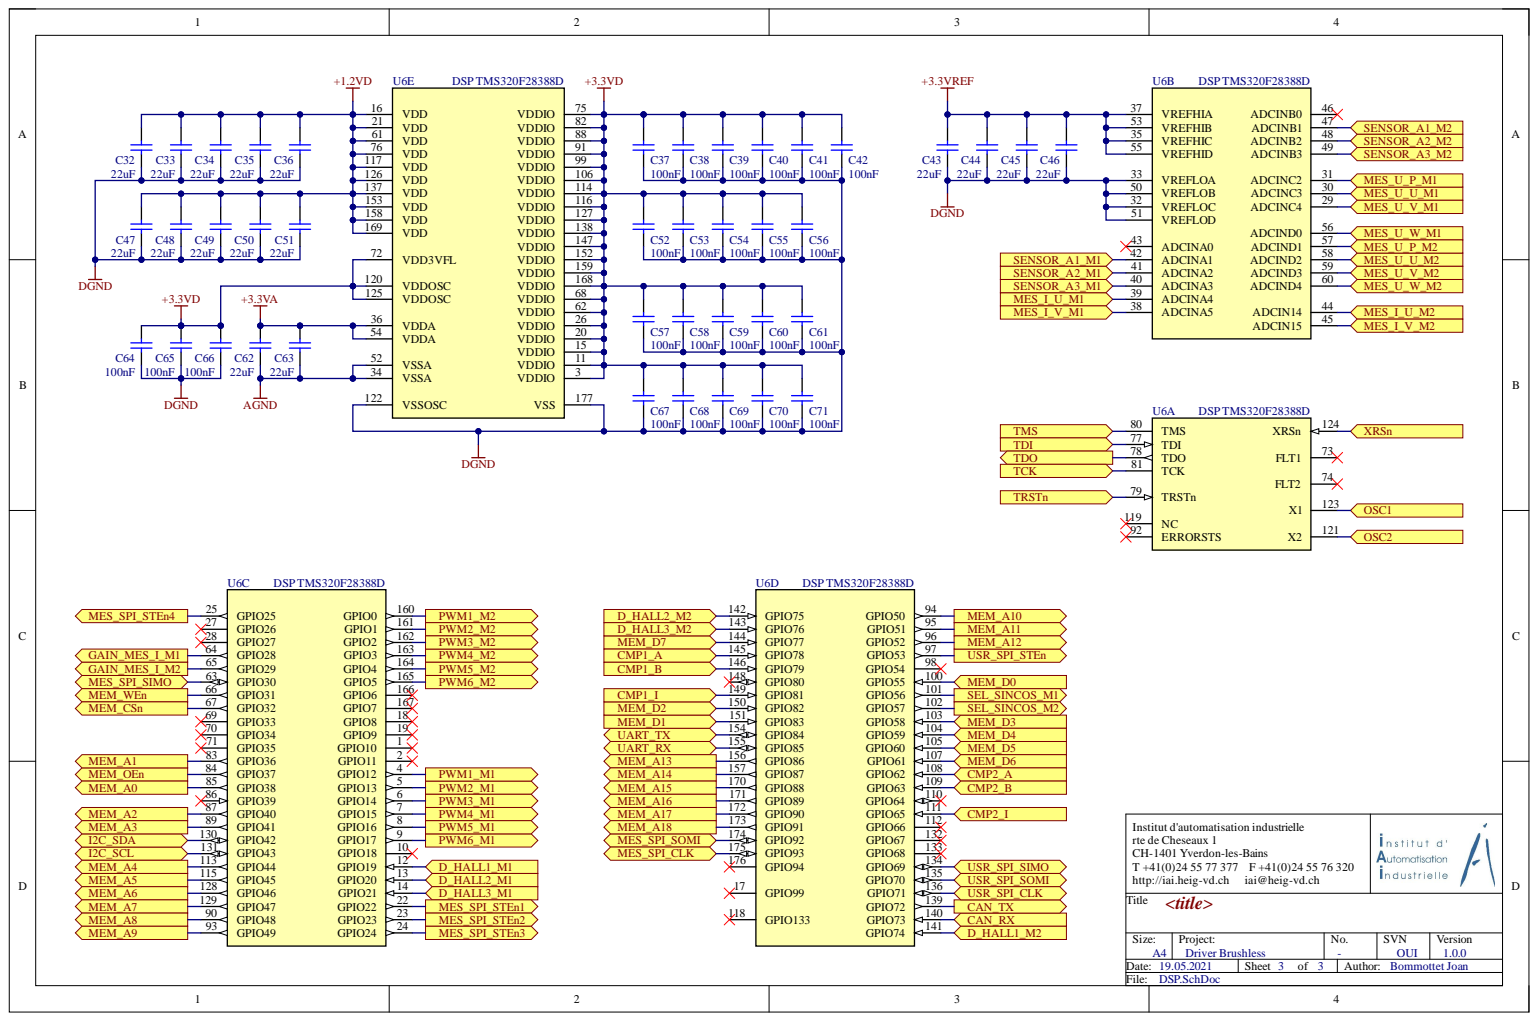
[picture p21: page 3]

VDD3VFL 72

VDDOSC 120

+3.3VA | VDDOSC 125

Institut d'automatisation industrielle
rte de Cheseaux 1
CH-1401 Yverdon-les-Bains
Title
<title>

Size: A4 | Project: Driver Brushless | No. - | SVN OUI | Version 1.0.0

Date: 19.05.2021 | Sheet 3 of 3 | Author: BommottetJoan
