jBommottet/TB-Driver-Brushless/Driver050621/InterfaceBoard/InterfaceBoard.pdf

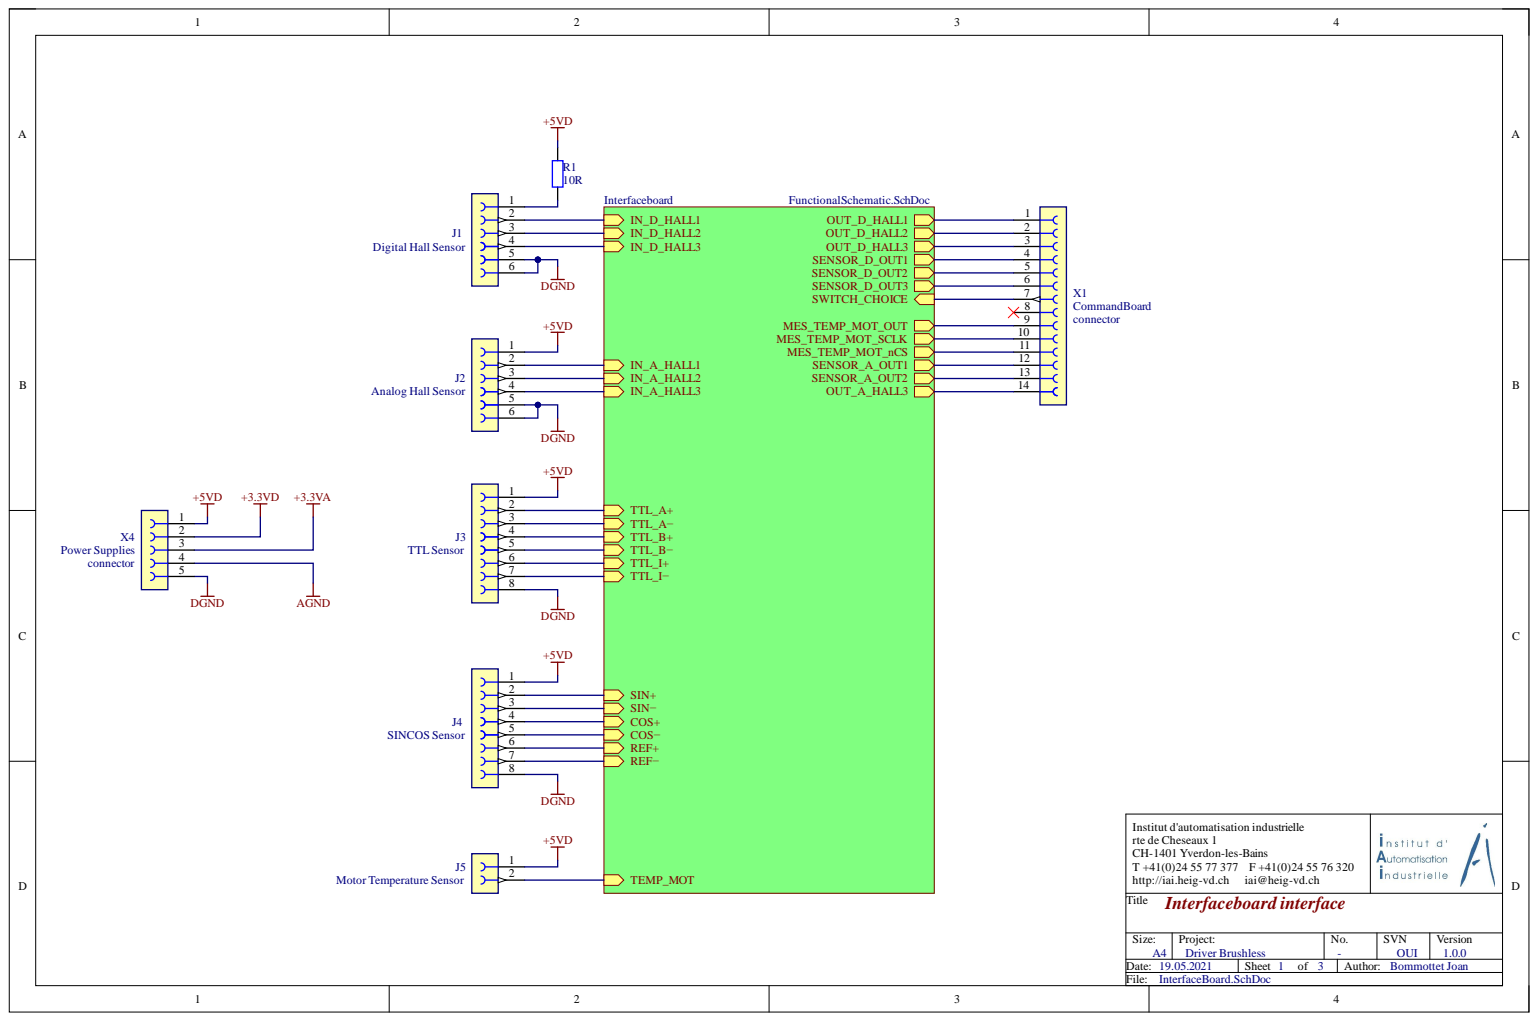
[picture p22: page 1]
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

Dat e : 19.05.2021 | Shee t o f | A u t h o r : Bommo t tet J o an

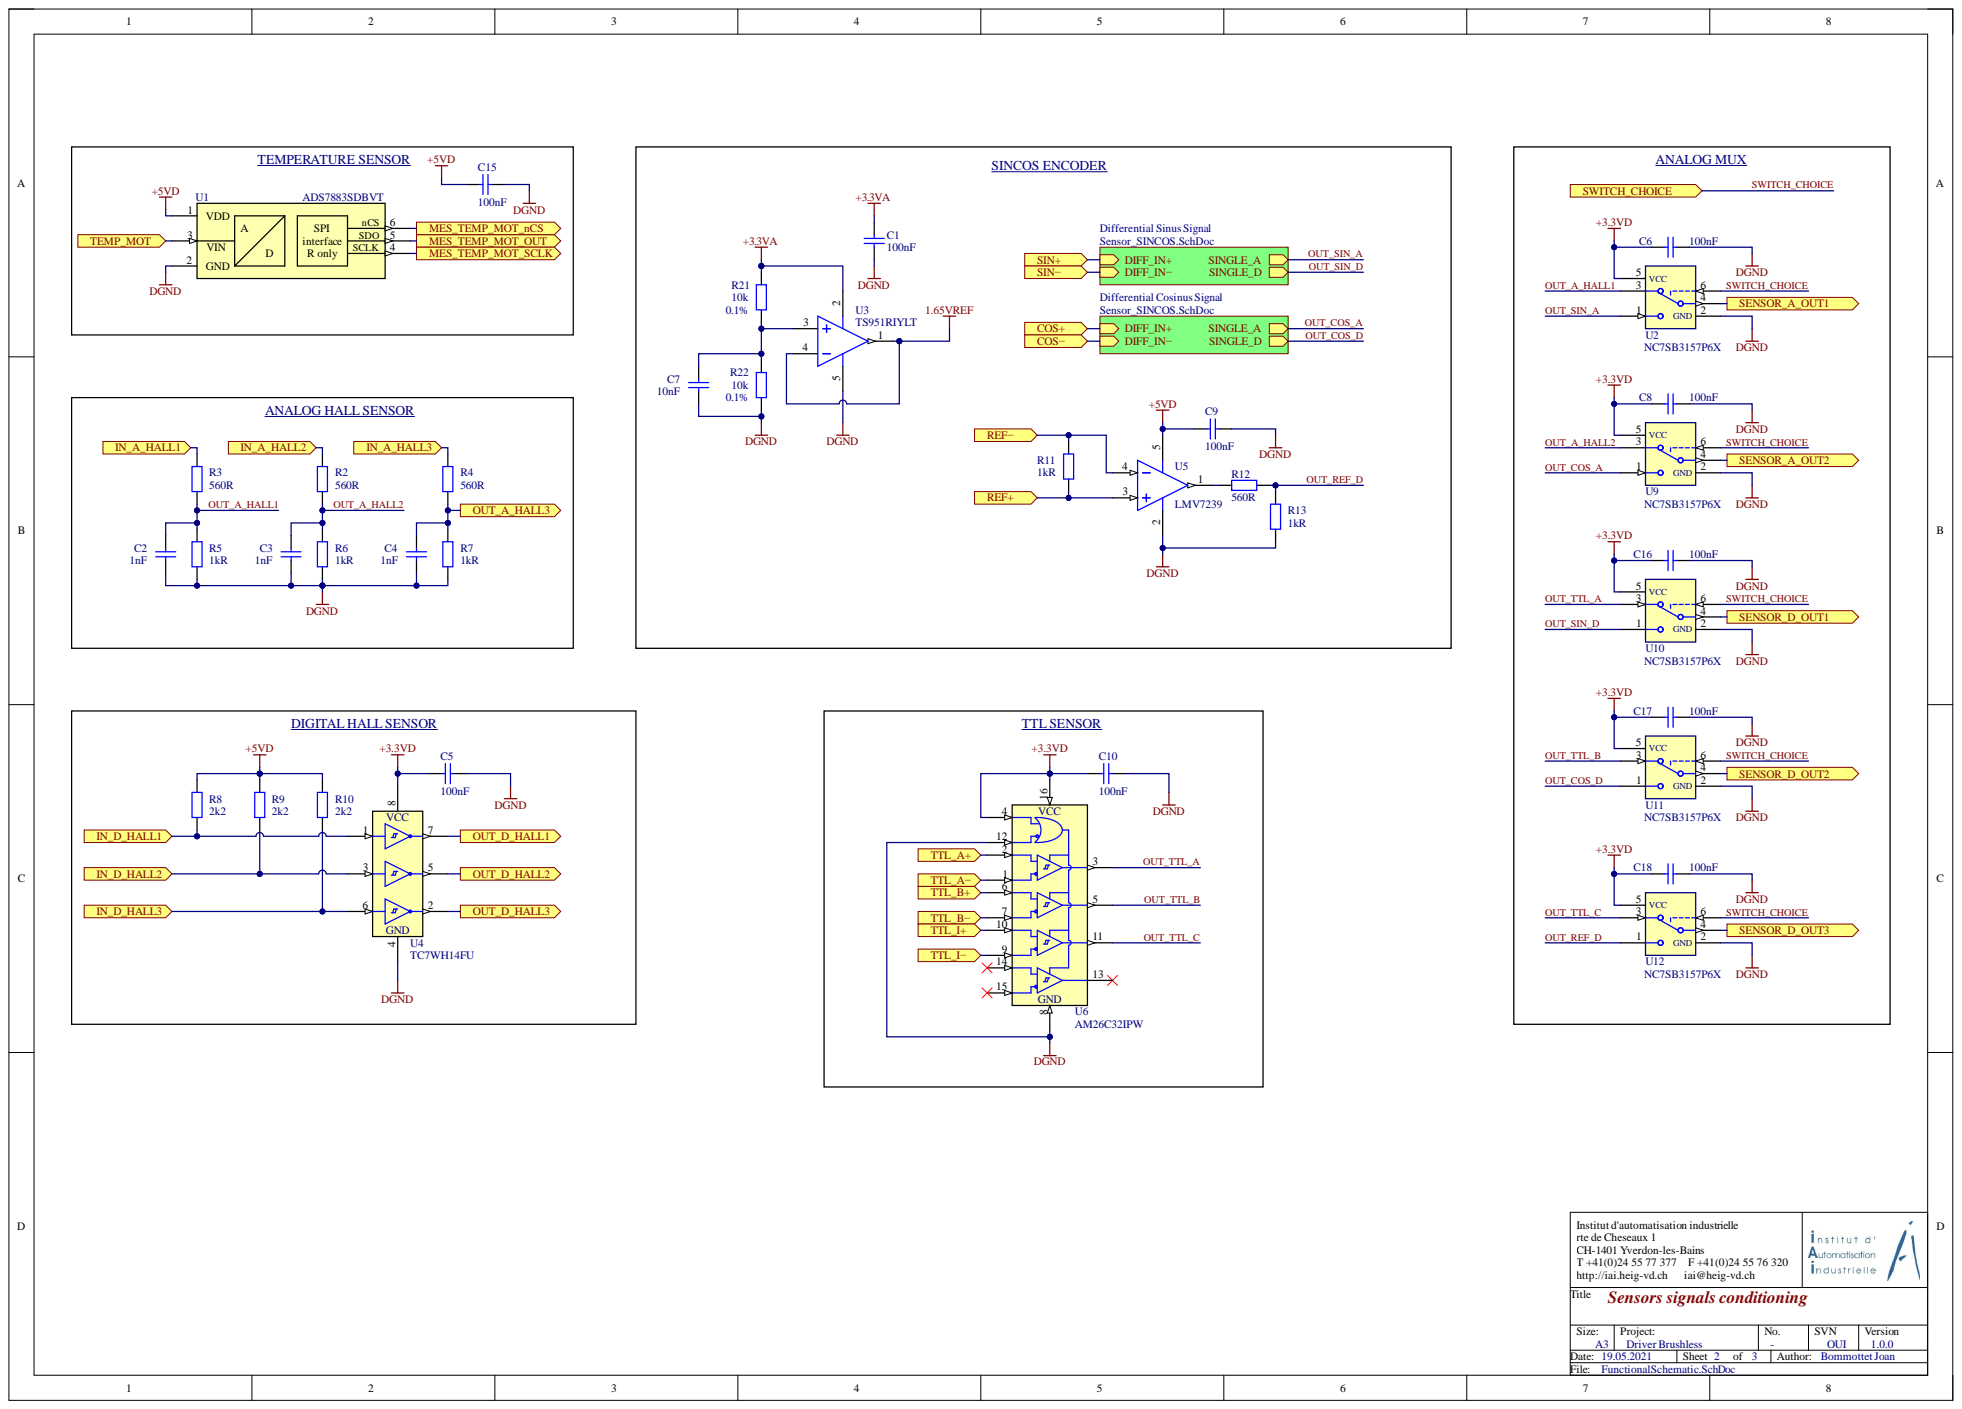
[picture p23: page 2]

SINCOS ENCODER TEMPERATURE SENSOR

Institut d'automatisation industrielle
rte de Cheseaux 1
CH-1401 Yverdon-les-Bains
Title
Sensors signals conditioning

Size: A3 | Project: DriverBrushless | No. - | SVN OUI | Version 1.0.0

Date: | Sheet 2 of 3 | Author: BommottetJoan

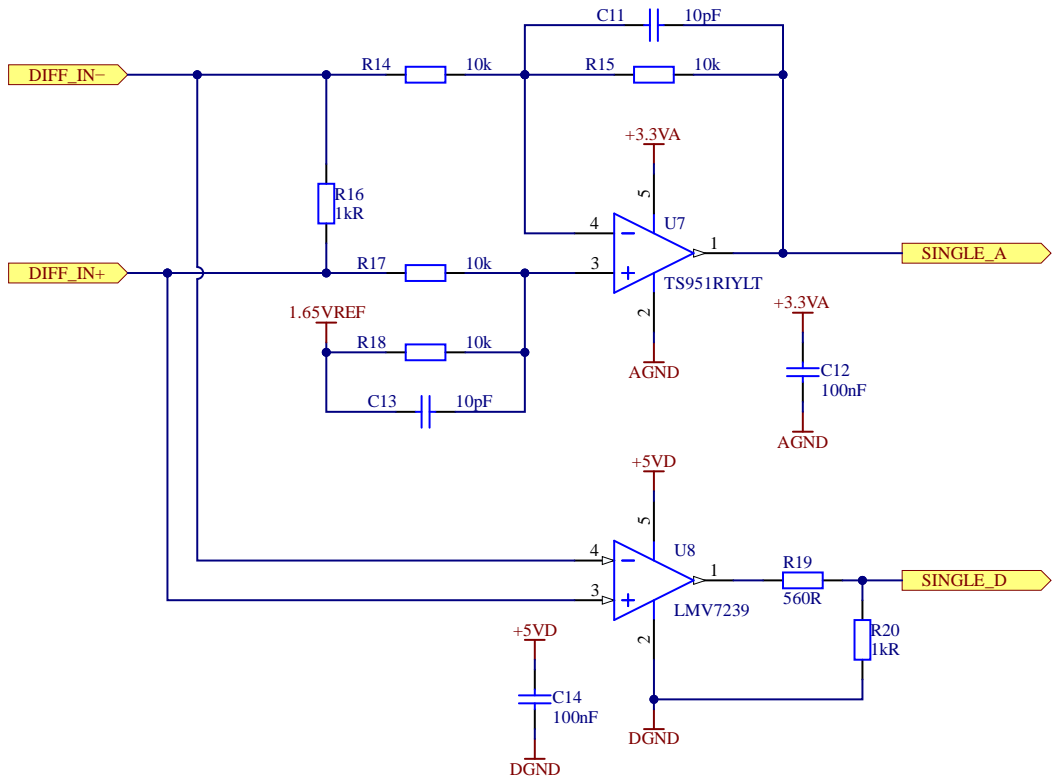
[picture p24: page 3]

Institut d'automatisation industrielle
rte de Cheseaux 1
CH-1401 Yverdon-les-Bains
Title
SINCOS sensor differential to single

Size: A4 | Project: Driver Brushless | No. - | SVN OUI | Version 1.0.0

Date: | Sheet 3 of 3 | Author: BommottetJoan
