jBommottet/TB-Driver-Brushless/Driver050621/CommandBoard/werwe.pdf

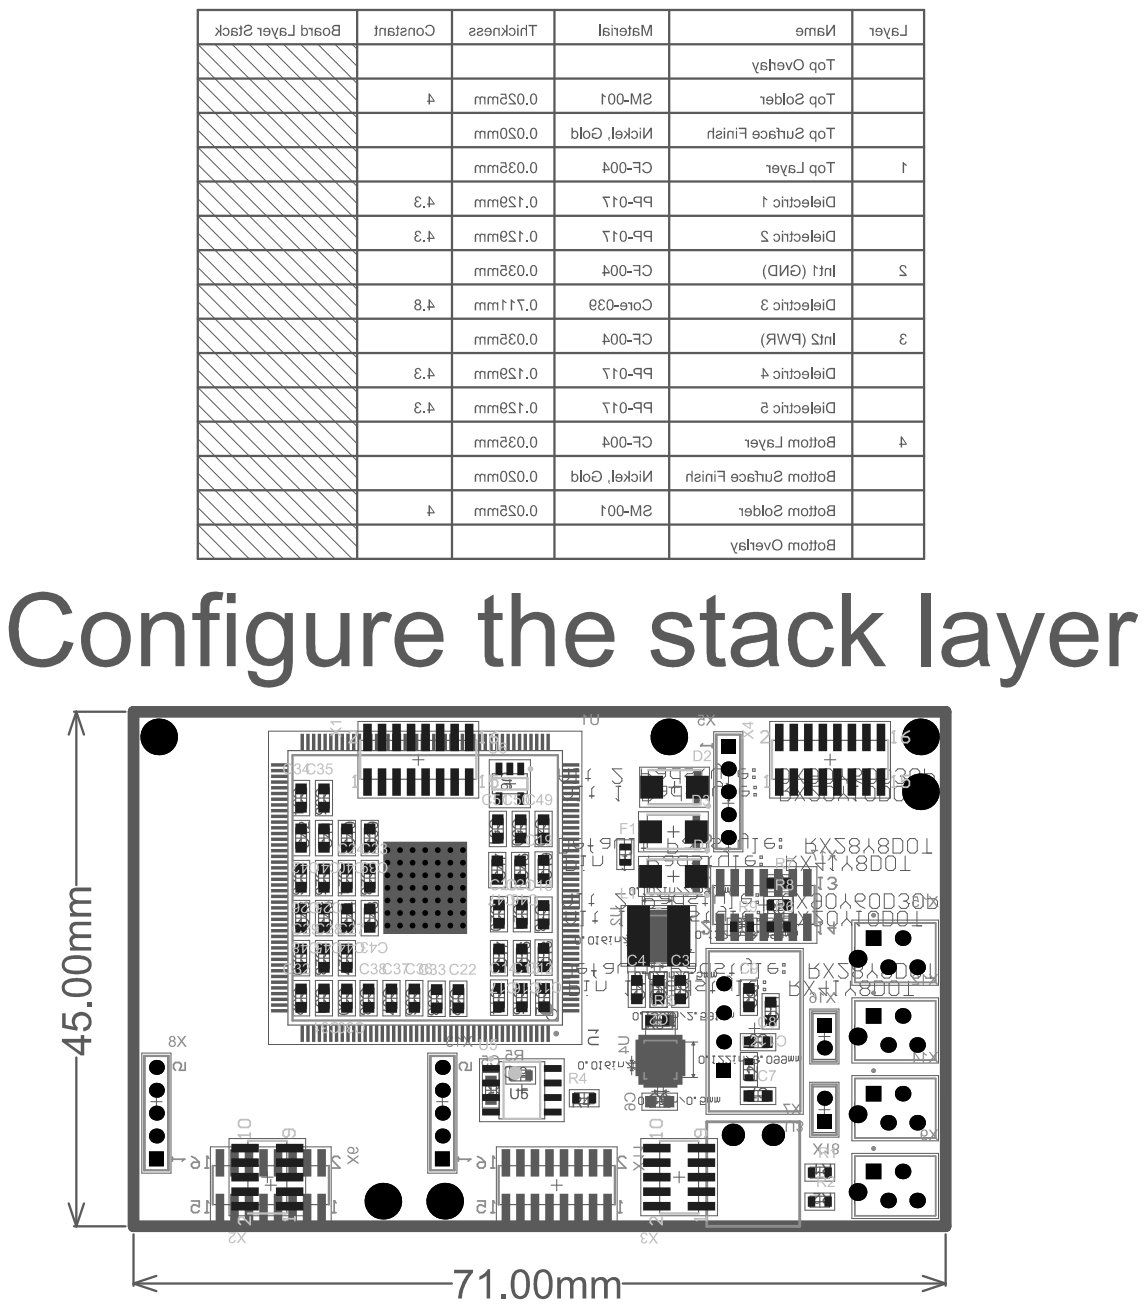
[picture p25: page 1]
