jBommottet/TB-Driver-Brushless/Driver050621/DCDC_5V/DCDC_5V.pdf

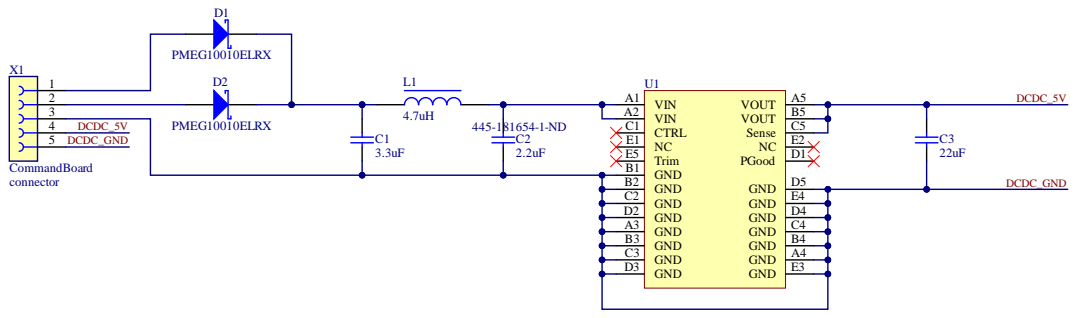
[picture p26: page 1]

Size : A 4 | Projec t : i A i _ Temp lateProj e c t | N o . N ° SG X | SV N O U I | Vers i o n 1.0 . 0

Dat e : 0 8.0 5 . 2 0 2 1 | Shee t 1 o f 1 | A u t h o r : PZ O
