jBommottet/TB-Driver-Brushless/(list of files, drawings)

Other design files:
Driver050621/CommandBoard/Alimentations.SchDoc
Driver050621/CommandBoard/CommandBoard.PcbDoc
Driver050621/CommandBoard/CommandBoard.PcbLib
Driver050621/CommandBoard/CommandBoard.PrjPcb
Driver050621/CommandBoard/CommandBoard.SchDoc
Driver050621/CommandBoard/CommandBoard.SchLib
Driver050621/CommandBoard/DSP.SchDoc
Driver050621/CommandBoard/FunctionalSchematic.SchDoc
Driver050621/CommandBoard/UD_composants/CX3225SB12000D0GZJC1/CX3225SB12000D0GZJC1.SchLib
Driver050621/CommandBoard/UD_composants/CX3225SB12000D0GZJC1/OSCCC320X250X60N.PcbLib
Driver050621/CommandBoard/UD_composants/LQH3NPN151MGRL/IND_LQH3NPN151MGRL.PcbLib
Driver050621/CommandBoard/UD_composants/LQH3NPN151MGRL/LQH3NPN151MGRL.SchLib
Driver050621/CommandBoard/UD_composants/ul_MPM3805GQB33Z/AltiumDesigner/2021-05-01_16-02-10/2021-05-01_16-02-10.PcbLib
Driver050621/CommandBoard/UD_composants/ul_MPM3805GQB33Z/AltiumDesigner/2021-05-01_16-02-10/2021-05-01_16-02-10.SchLib
Driver050621/DCDC_5V/DCDC_5V.PcbDoc
Driver050621/DCDC_5V/DCDC_5V.PcbLib
Driver050621/DCDC_5V/DCDC_5V.PrjPcb
Driver050621/DCDC_5V/DCDC_5V.SchDoc
Driver050621/DCDC_5V/DCDC_5V.SchLib
Driver050621/DCDC_5V/UD_Composant/RPMH5.0-1.5/CONV_RPMH5.0-1.5.PcbLib
Driver050621/DCDC_5V/UD_Composant/RPMH5.0-1.5/RPMH5.0-1.5.SchLib
Driver050621/InterfaceBoard/FunctionalSchematic.SchDoc
Driver050621/InterfaceBoard/InterfaceBoard.PcbDoc
Driver050621/InterfaceBoard/InterfaceBoard.PcbLib
Driver050621/InterfaceBoard/InterfaceBoard.PrjPcb
Driver050621/InterfaceBoard/InterfaceBoard.SchDoc
Driver050621/InterfaceBoard/InterfaceBoard.SchLib
Driver050621/InterfaceBoard/Sensor_SINCOS.SchDoc
Driver050621/InterfaceBoard/UD_Composant/7-188275-6/SnapEDApcb.PcbLib
Driver050621/InterfaceBoard/UD_Composant/7-188275-6/SnapEDAsch.SchLib
Driver050621/InterfaceBoard/UD_Composant/7-188275-8/SnapEDApcb.PcbLib
Driver050621/InterfaceBoard/UD_Composant/7-188275-8/SnapEDAsch.SchLib
Driver050621/PowerBoard/Pont_Triphase.SchDoc
Driver050621/PowerBoard/PowerBoard.PcbDoc
Driver050621/PowerBoard/PowerBoard.PcbLib
Driver050621/PowerBoard/PowerBoard.PrjPcb
Driver050621/PowerBoard/PowerBoard.SchDoc
Driver050621/PowerBoard/PowerBoard.SchLib
Driver050621/PowerBoard/UD_Componant/BG306-04-A-1-0400-X-X_REVD/SnapEDApcb.PcbLib
Driver050621/PowerBoard/UD_Componant/BG306-04-A-1-0400-X-X_REVD/SnapEDAsch.SchLib
Driver050621/PowerBoard/UD_Componant/connector4pins/Altium_WR-PHD (rev20a)/WR-PHD_Pin Header_1.27mm.PcbLib
Driver050621/PowerBoard/UD_Componant/connector4pins/Altium_WR-PHD (rev20a)/WR-PHD_Pin Header_1.27mm.SchLib
Driver050621/PowerBoard/UD_Componant/connector4pins/Altium_WR-PHD (rev20a)/WR-PHD_Pin Header_2.00mm.SchLib
Driver050621/PowerBoard/UD_Componant/connector4pins/Altium_WR-PHD (rev20a)/WR-PHD_Pin Header_2.54mm.SchLib
Driver050621/PowerBoard/UD_Componant/connector4pins/Altium_WR-PHD (rev20a)/WR-PHD_Socket Header_1.27mm.PcbLib
Driver050621/PowerBoard/UD_Componant/connector4pins/Altium_WR-PHD (rev20a)/WR-PHD_Socket Header_1.27mm.SchLib
Driver050621/PowerBoard/UD_Componant/connector4pins/Altium_WR-PHD (rev20a)/WR-PHD_Socket Header_2.00mm.SchLib
Driver050621/PowerBoard/UD_Componant/connector4pins/Altium_WR-PHD (rev20a)/WR-PHD_Socket Header_2.54mm.SchLib
Driver050621/PowerBoard/UD_Componant/ul_NTMFSC004N08MC/AltiumDesigner/2021-04-29_10-36-20/2021-04-29_10-36-20.PcbLib
Driver050621/PowerBoard/UD_Componant/ul_NTMFSC004N08MC/AltiumDesigner/2021-04-29_10-36-20/2021-04-29_10-36-20.SchLib
