jBommottet/TB-Driver-Brushless/(commit log)

2021-02-23 Création du document de la spécification
2021-02-28 Update Specification & Plannification
    [Planification_V1.xlsx]
2021-03-02 update spécification
    [Planification_V1.xlsx]
2021-03-02 update spec & planif
    [Planification_V1.xlsx]
2021-03-03 update planif et spec
    [Planification.xlsx]
2021-03-09 Update specification et Maj du planning
    [Planification.xlsx]
2021-06-05 version 05.06.2021
    [2021-04-29_10-36-20.PcbLib, 2021-04-29_10-36-20.SchLib, 2021-05-01_16-02-10.PcbLib, 2021-05-01_16-02-10.SchLib, 62000611121 (rev1).stp, 62000611121-5pin.stp, 62000611821-2pin.stp, 62000611821-3pin.stp]
2021-07-28 Update planif + Prj. Status
    [Planification.xlsx]
