jBommottet/TB-Driver-Brushless/(notices)

Notices in the files:
Driver050621/PowerBoard/UD_Componant/GCT_BG30604A10400LB/BG306-04-A-1-0400-L-B.stp:
FILE_NAME( 'p:/temp/worker_87/temp/exporttempdir_3528_574_GWw05/format_0/BG306-04-A-1-0400-L-B.stp', '2021-04-29T16:39:45', ( 'License CC BY-ND 4.0' ), ( 'CADENAS' ), ' ', 'PARTsolutions', ' ' );
